ondrejh/keg_scale/doc/ptt2/dac_wiring.jpg

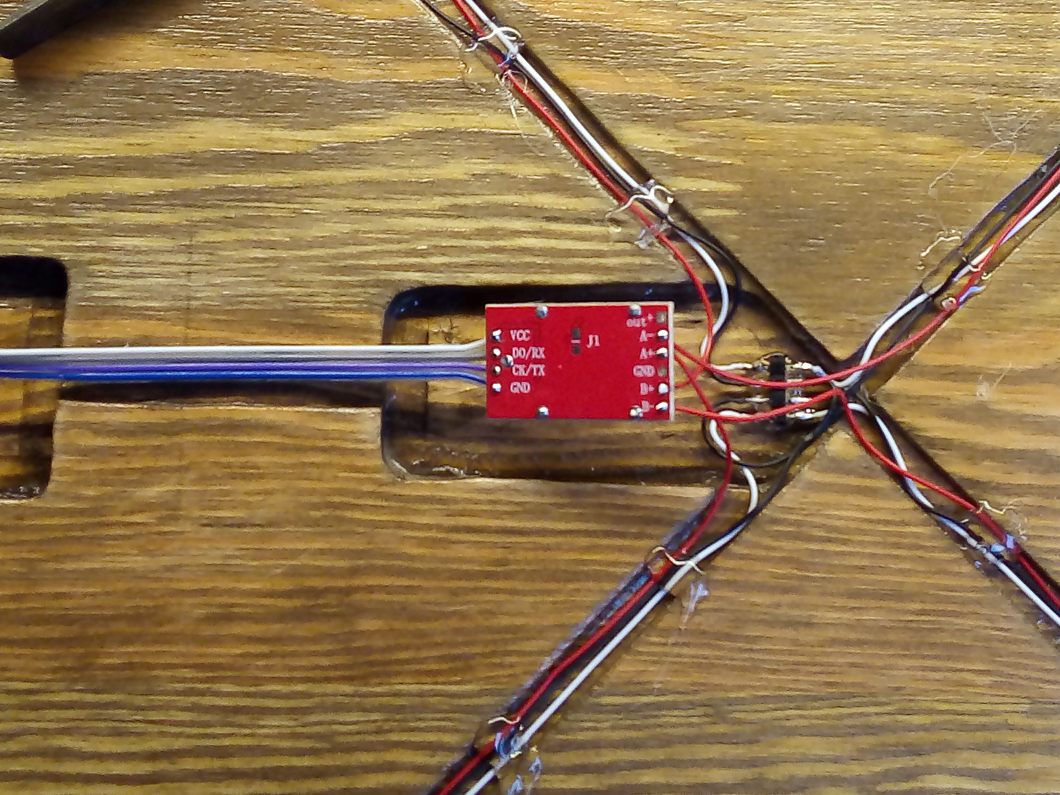
doc/ptt2/dac_wiring.jpg
