ondrejh/keg_scale/doc/gauge/gauge_prototype.jpg

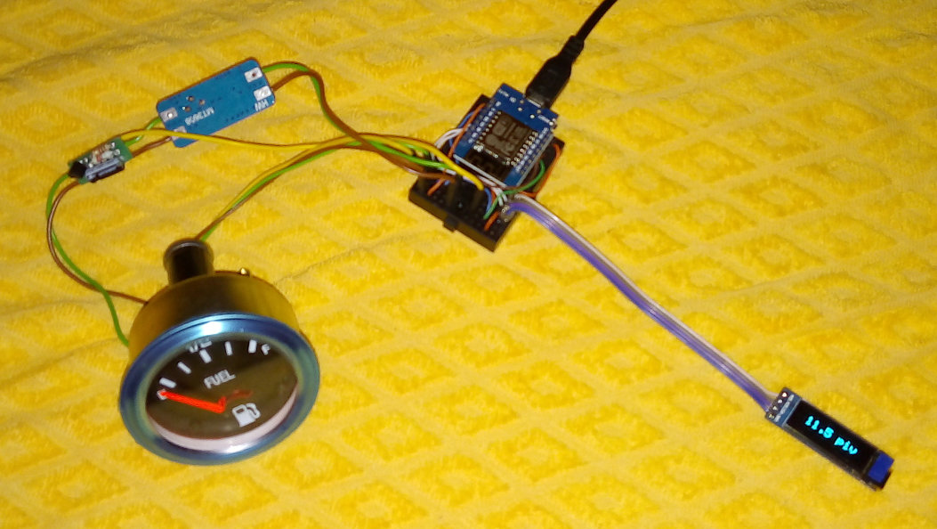
doc/gauge/gauge_prototype.jpg
