ondrejh/keg_scale/doc/hw1/keg01.png

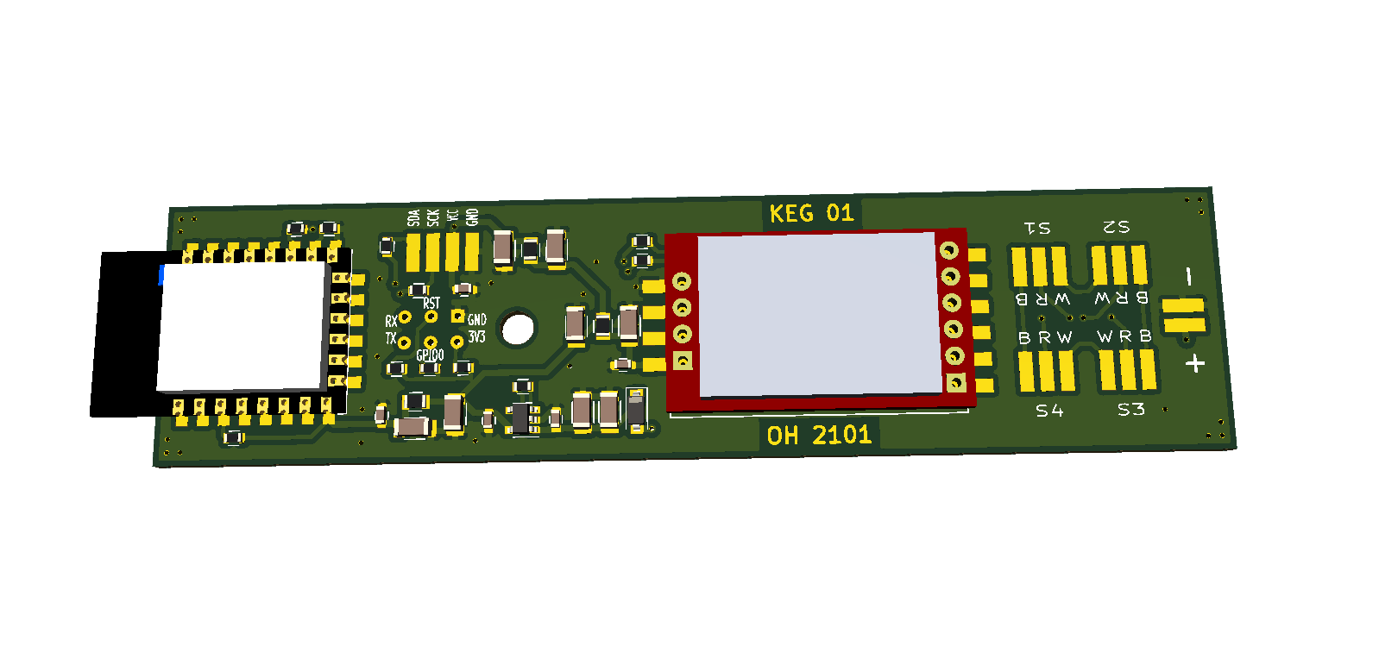
doc/hw1/keg01.png
