ondrejh/keg_scale/doc/hw1/prog.png

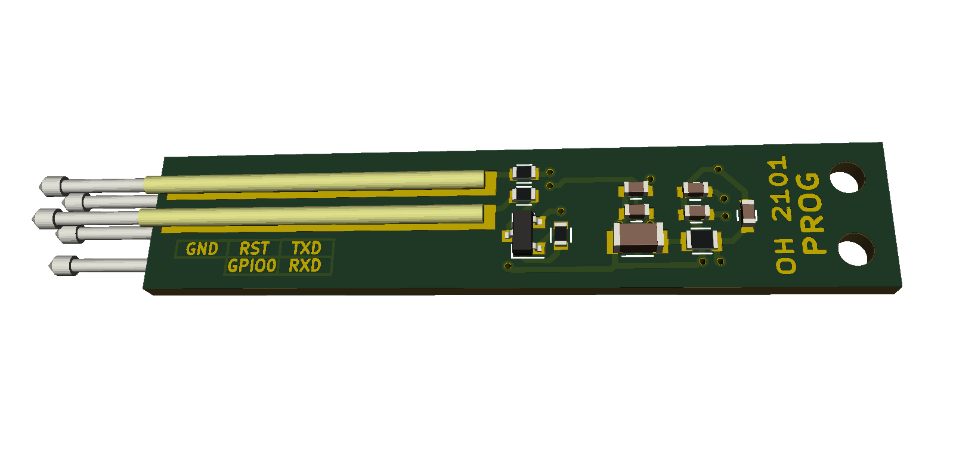
doc/hw1/prog.png
