ondrejh/keg_scale/doc/hw2/keg02.png

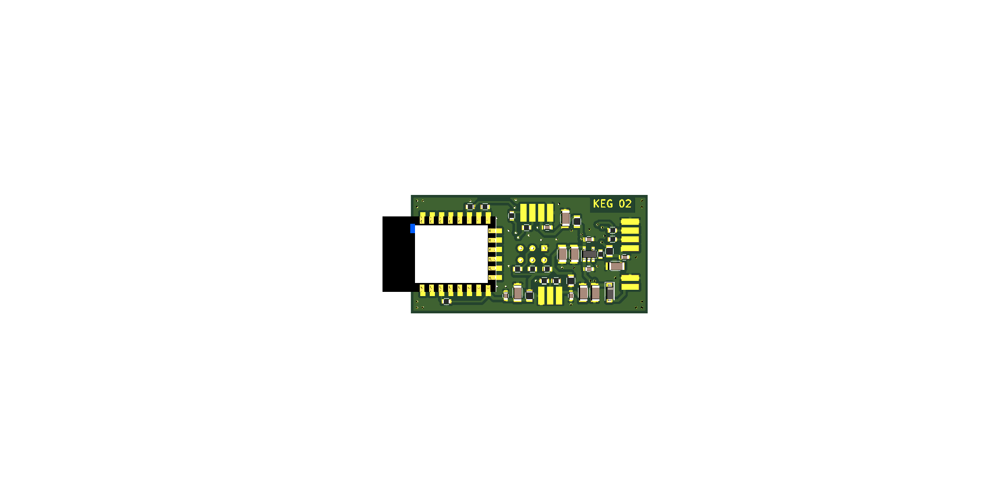
doc/hw2/keg02.png
