ondrejh/keg_scale/model/TO-92_Inline.step

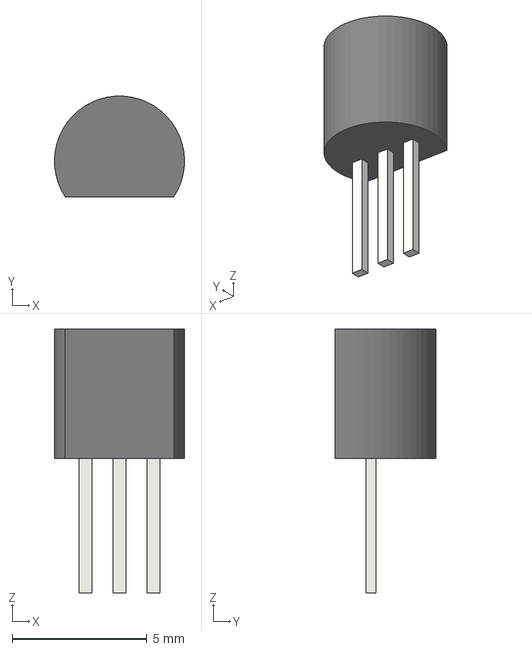
[picture p6: CAD file, 2021-11-08]
model/TO-92_Inline.step
4.83 x 3.74 x 9.80 mm
