ondrejh/keg_scale/schematic/keg01/keg01.step

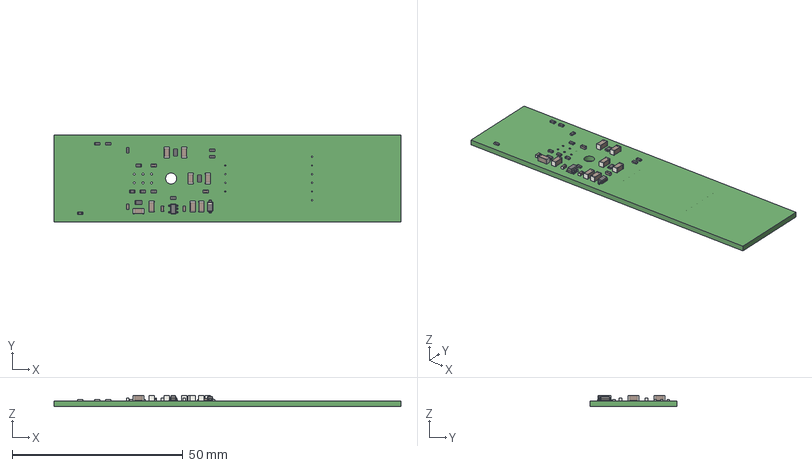
[picture p7: CAD file, 2021-03-22]
schematic/keg01/keg01.step
101.6 x 25.4 x 3.25 mm
hx711_shl
ESP-12E
