ondrejh/keg_scale/model/base_plate_small.FCStd

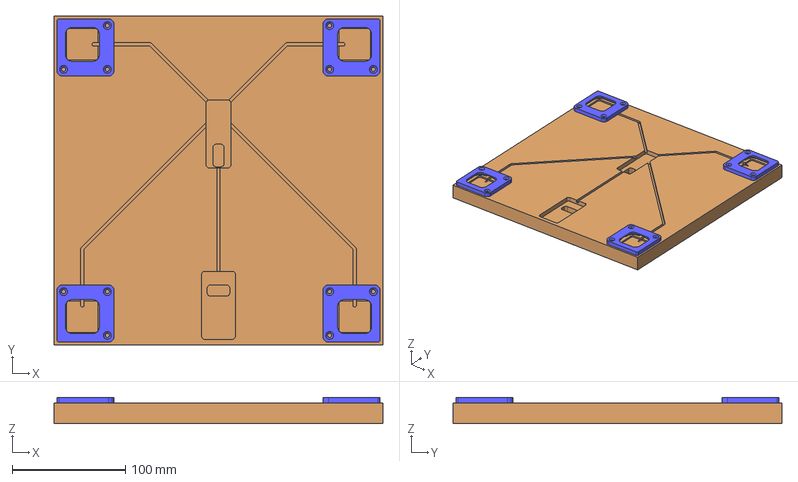
[picture p8: CAD file, 2021-11-08]
model/base_plate_small.FCStd
290.0 x 290.0 x 23.0 mm
teleso_male
noha1
noha2
noha3
noha4
OLED_0.91_128x034
