ondrejh/keg_scale/model/Cella_car.stp

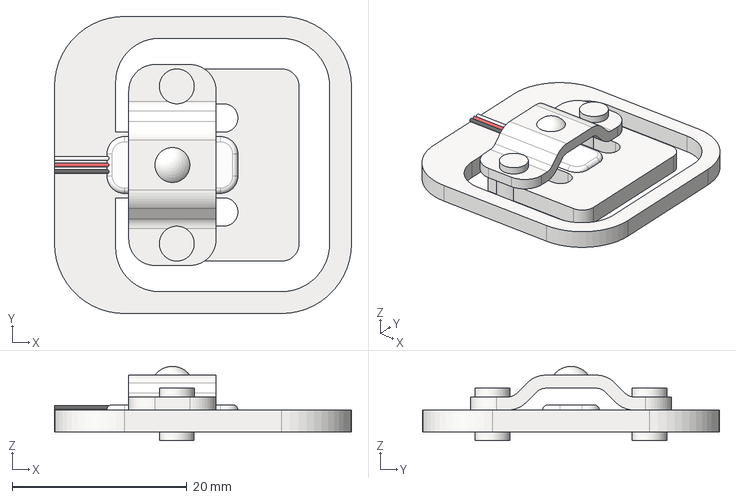
[picture p9: CAD file, 2021-05-28]
model/Cella_car.stp
34.0 x 34.0 x 8.50 mm
