ondrejh/keg_scale/model/BC559B.step

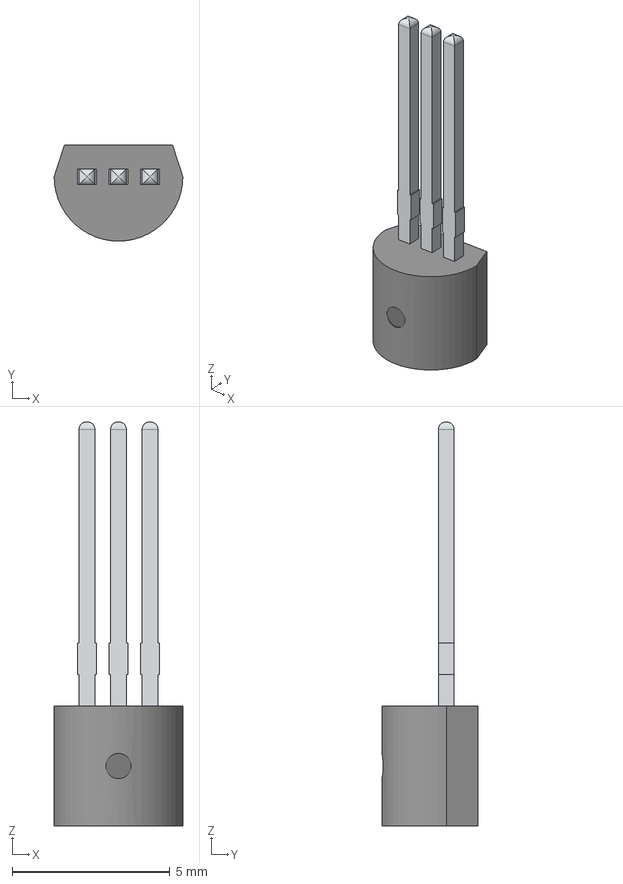
[picture p10: CAD file, 2021-05-28]
model/BC559B.step
4.08 x 3.05 x 12.8 mm
