ondrejh/keg_scale/model/Euro Keg 30L.stp

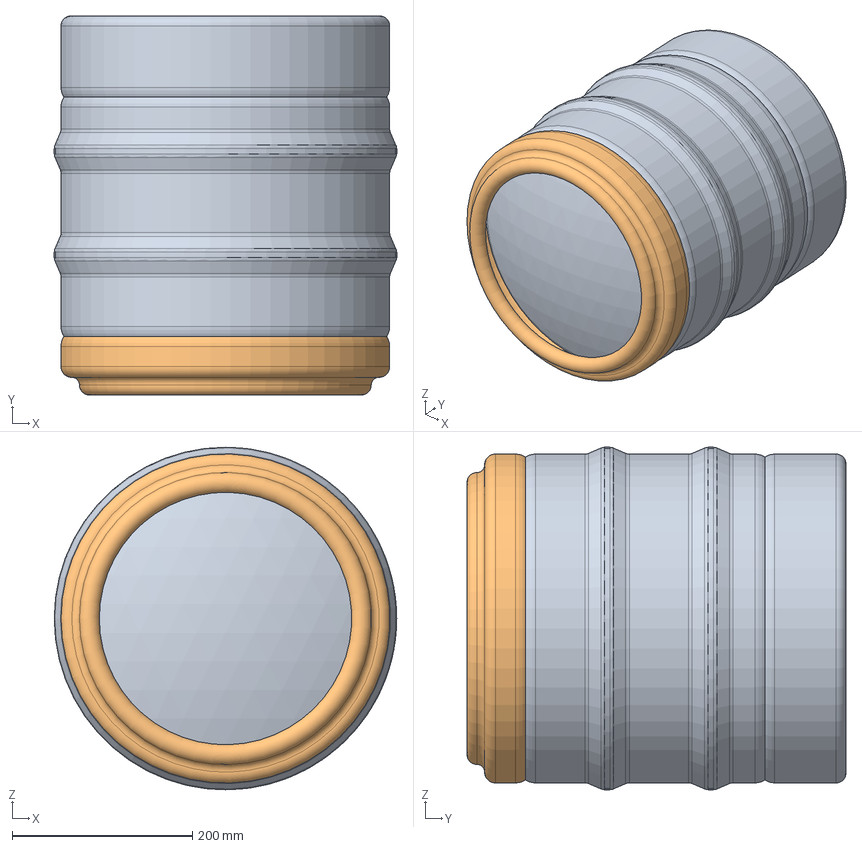
[picture p11: CAD file, 2021-05-28]
model/Euro Keg 30L.stp
380.0 x 420.5 x 380.0 mm
