ondrejh/keg_scale/model/USB Type-C Plug -1.STEP

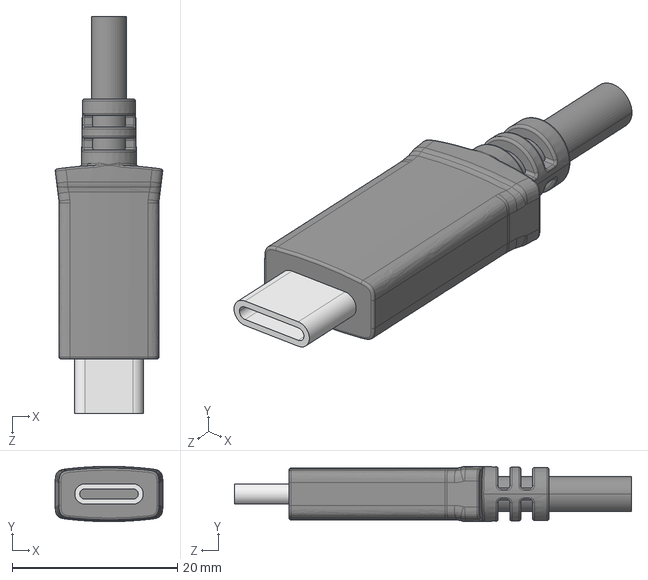
[picture p12: CAD file, 2021-05-28]
model/USB Type-C Plug -1.STEP
13.0 x 6.70 x 48.1 mm
