ondrejh/keg_scale/model/Micro USB Plug.step

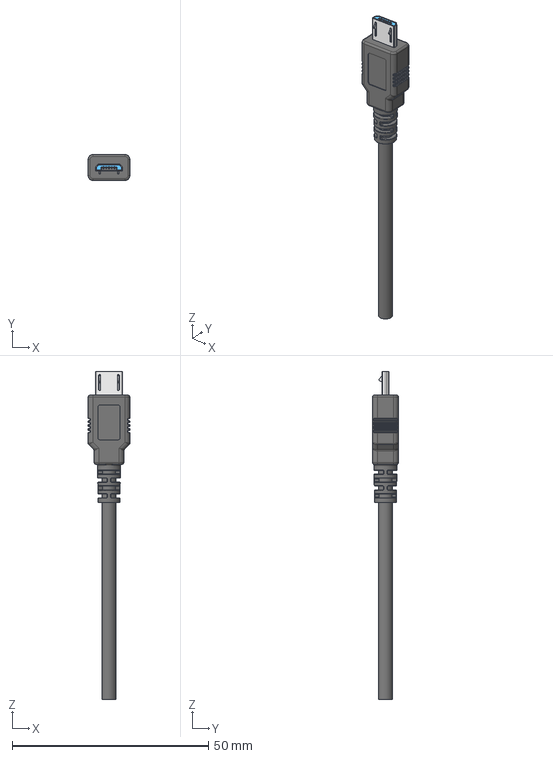
[picture p13: CAD file, 2021-05-28]
model/Micro USB Plug.step
10.6 x 6.60 x 83.5 mm
Cable
Micro_USB_Plug_Connector
