ondrejh/keg_scale/model/pogo.FCStd

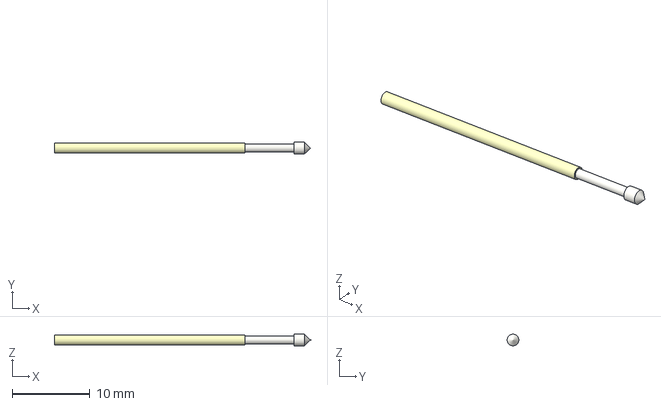
[picture p15: CAD file, 2021-01-06]
model/pogo.FCStd
33.0 x 1.50 x 1.50 mm
HOLDER
PIN
