ondrejh/keg_scale/model/hx711.FCStd

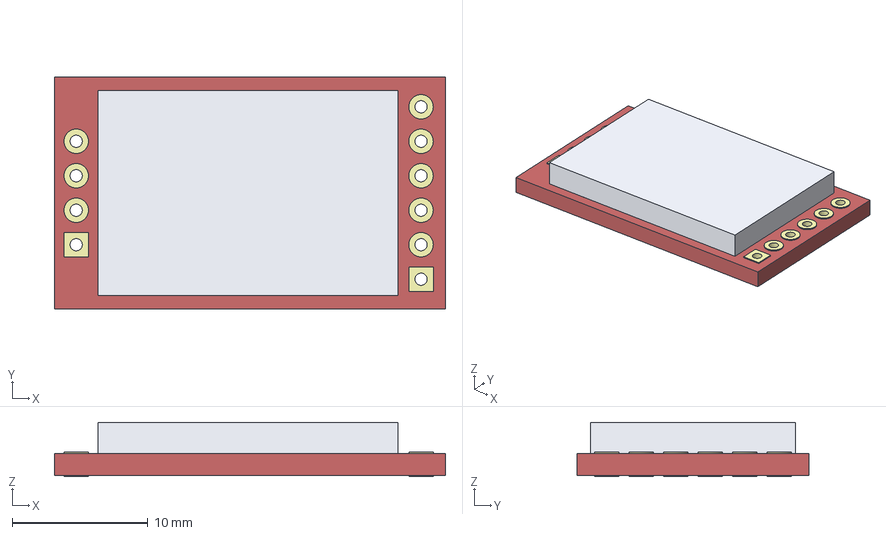
[picture p16: CAD file, 2021-01-05]
model/hx711.FCStd
28.8 x 17.1 x 4.00 mm
PCB
RoundPad01
SquarePad01
RoundPad02
RoundPad03
RoundPad04
RoundPad05
RoundPad06
RoundPad07
RoundPad08
SquarePad02
Cover
