ondrejh/keg_scale/model/vaha1.stp

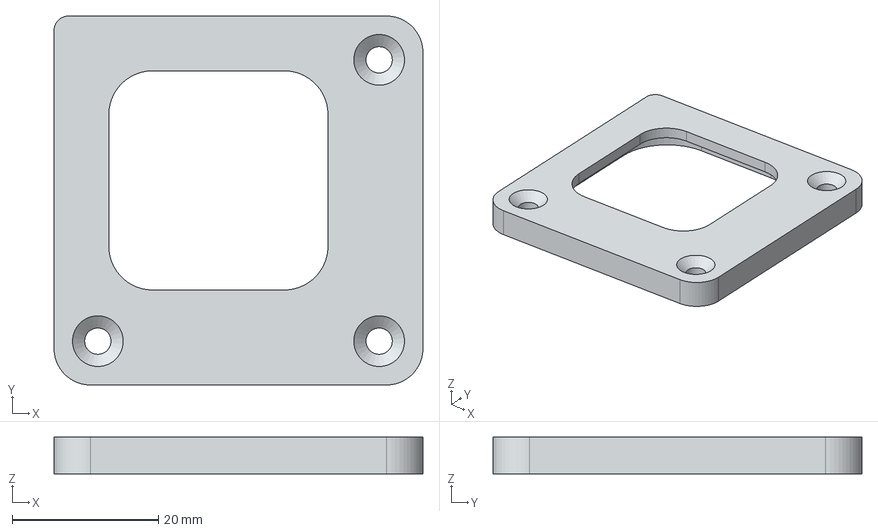
[picture p17: CAD file, 2020-05-13]
model/vaha1.stp
50.5 x 50.5 x 5.00 mm
