ondrejh/keg_scale/(list of files, cad)

Other CAD files:
model/vaha1.stl
