ondrejh/keg_scale/doc/base_plate_small-spodek.pdf

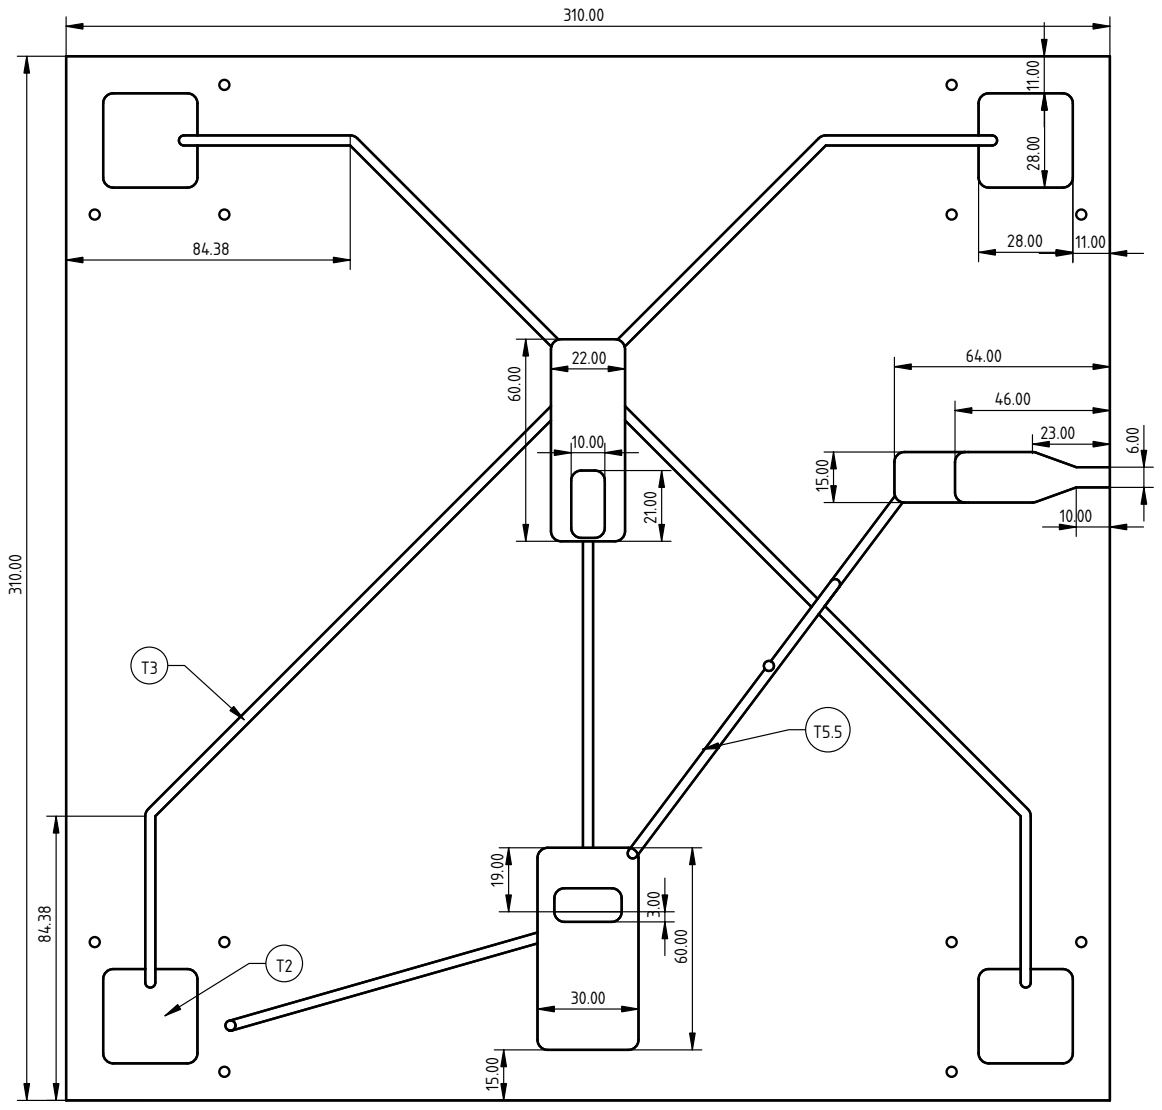
[picture p18: page 1]
