ondrejh/keg_scale/doc/base_plate_small-vrsek.pdf

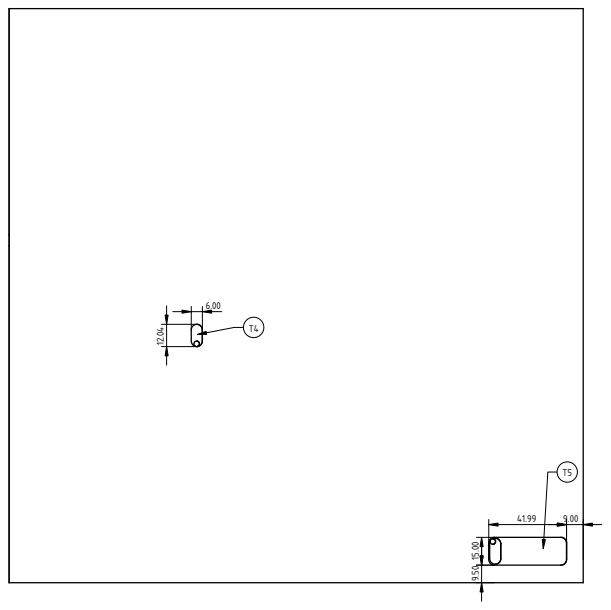
[picture p19: page 1]
