ondrejh/keg_scale/schematic/gauge_folower.asc

C1: cap; 10µ
Q1: npn
R1: res; 200
R2: res; 33k
R3: res; 10k
R4: res; 33k
U1: OP727
U2: OP727
V1: voltage; 12
V2: voltage; PULSE(0 3.3 0 0 0 0.99m 1m)
Named nets: 0
.tran 2
