ondrejh/keg_scale/schematic/keg02/keg02.kicad_pcb

## KiCad design schematic/keg02/keg02.kicad_pcb (2021-05-28)

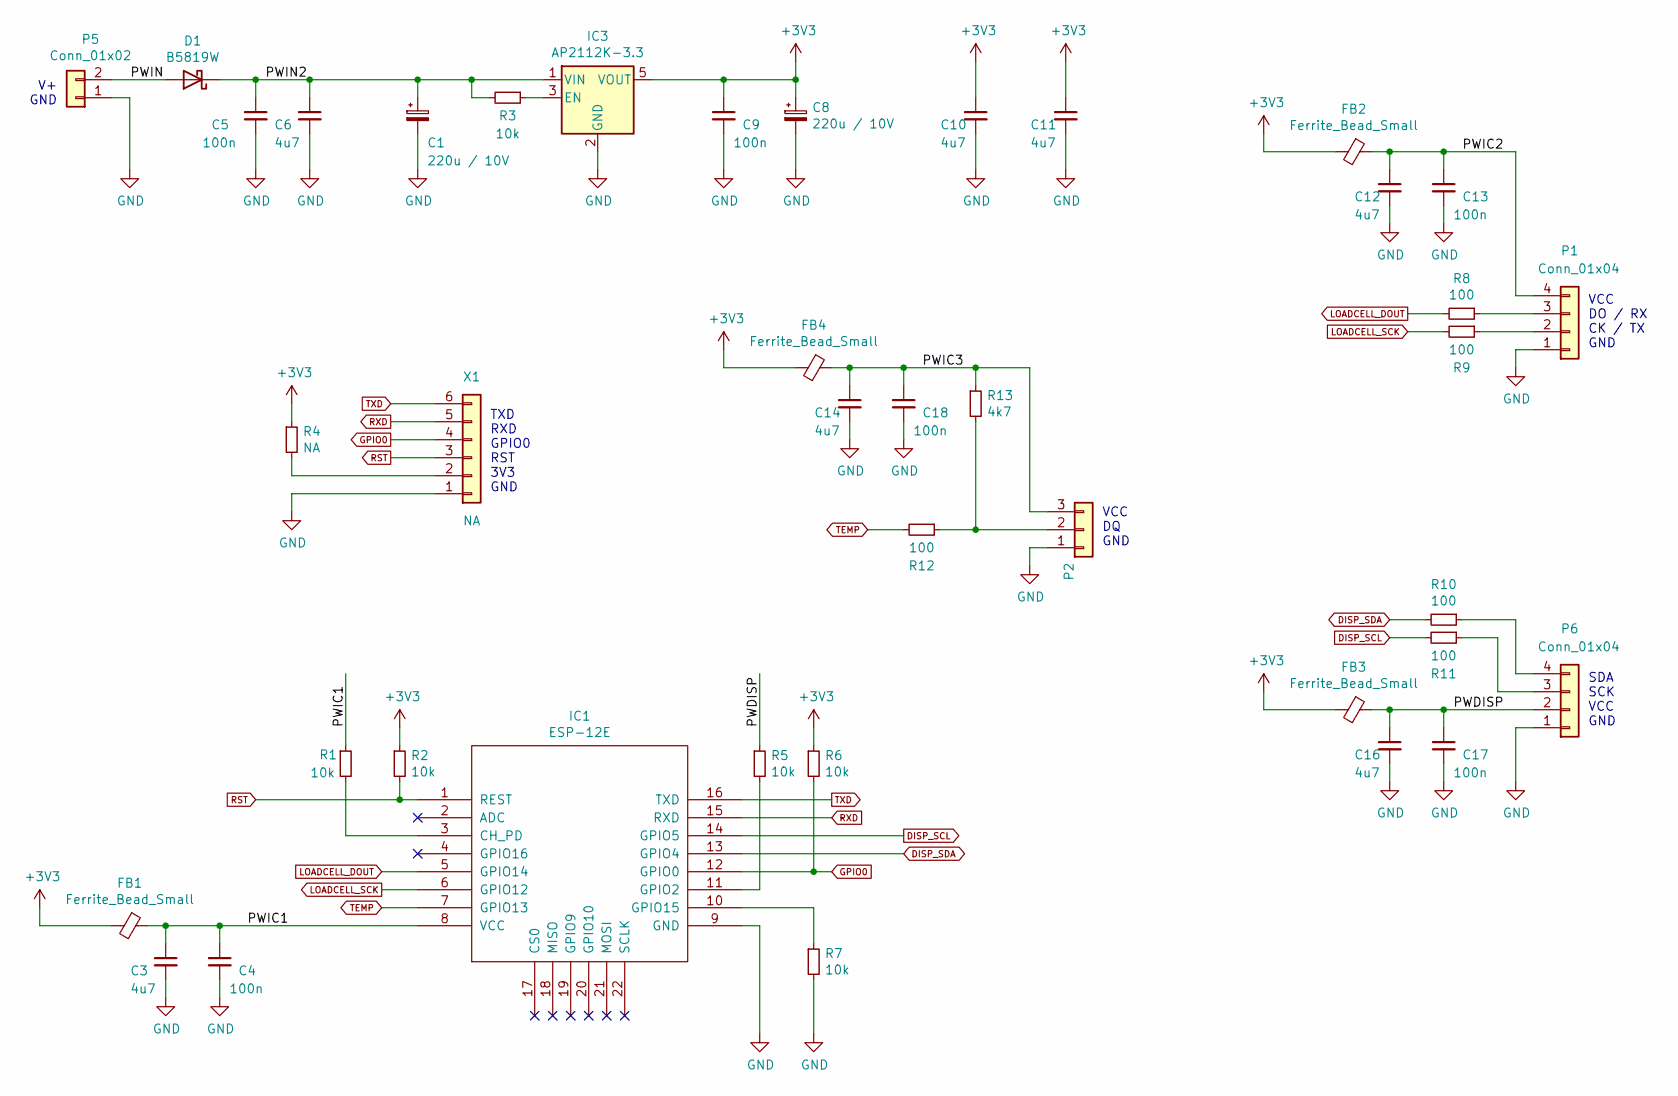
[picture p20: schematic keg02.sch]

Parts:
C1, C8: 220u / 10V; CP_Elec_6.3x7.7
C3, C6, C10, C11, C12, C14, C16: 4u7; C_1206
C4, C5, C9, C13, C17, C18: 100n; C_0603
D1: B5819W; D_SOD-123
FB1, FB2, FB3, FB4: Ferrite_Bead_Small; R_0805
IC1: ESP-12E; ESP-12E_SMD
IC3: AP2112K-3.3; SOT-23-5
P1, P6: Conn_01x04; DISP_CONN
P2: Conn_01x03; LC_CONN
P5: Conn_01x02; PWR_CONN
R1, R2, R3, R5, R6, R7: 10k; R_0603
R4: NA; R_0603
R8, R9, R10, R11, R12: 100; R_0603
R13: 4k7; R_0603
X1: NA; PROG_CON

Connections:
+3V3: C8.1, C9.1, C10.1, C11.1, FB1.2, FB2.2, FB3.2, FB4.2, IC3.5 (VOUT), R2.1, R4.1, R6.1
/PWDISP: C16.1, C17.1, FB3.1, P6.2, R5.1
/PWIC1: C3.1, C4.1, FB1.1, IC1.8 (VCC), R1.1
/PWIC2: C12.1, C13.1, FB2.1, P1.4
/PWIC3: C14.1, C18.1, FB4.1, P2.3, R13.1
/PWIN: D1.2 (A), P5.2
/PWIN2: C1.1, C5.1, C6.1, D1.1 (K), IC3.1 (VIN), R3.2
DISP_SCL: IC1.14 (GPIO5), R11.2
DISP_SDA: IC1.13 (GPIO4), R10.2
GND: C1.2, C3.2, C4.2, C5.2, C6.2, C8.2, C9.2, C10.2, C11.2, C12.2, C13.2, C14.2, C16.2, C17.2, C18.2, IC1.9 (GND), IC3.2 (GND), P1.1, P2.1, P5.1, P6.1, R7.2, X1.1
GPIO0: IC1.12 (GPIO0), R6.2, X1.4
LOADCELL_DOUT: IC1.5 (GPIO14), R8.2
LOADCELL_SCK: IC1.6 (GPIO12), R9.2
unnamed: IC1.3 (CH_PD), R1.2
unnamed: IC1.10 (GPIO15), R7.1
unnamed: IC1.11 (GPIO2), R5.2
unnamed: IC3.3 (EN), R3.1
unnamed: P1.2, R9.1
unnamed: P1.3, R8.1
unnamed: P2.2, R12.1, R13.2
unnamed: P6.3, R11.1
unnamed: P6.4, R10.1
unnamed: R4.2, X1.2
RST: IC1.1 (REST), R2.2, X1.3
RXD: IC1.15 (RXD), X1.5
TEMP: IC1.7 (GPIO13), R12.2
TXD: IC1.16 (TXD), X1.6

Notes on the sheet:
TXD RXD GPIO0 RST 3V3 GND
SDA SCK VCC GND
V+ GND
VCC DO / RX CK / TX GND
VCC DQ GND

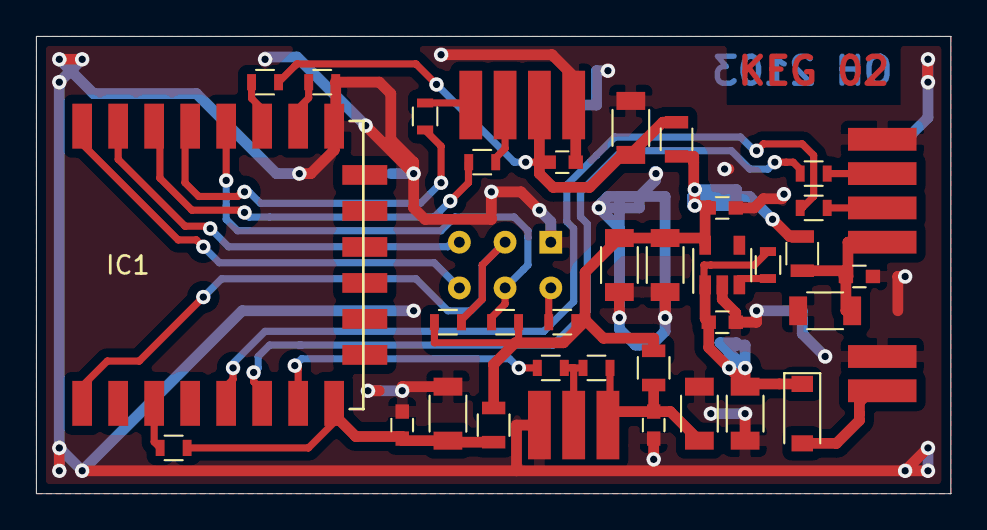
[picture p21: board keg02.kicad_pcb from above]

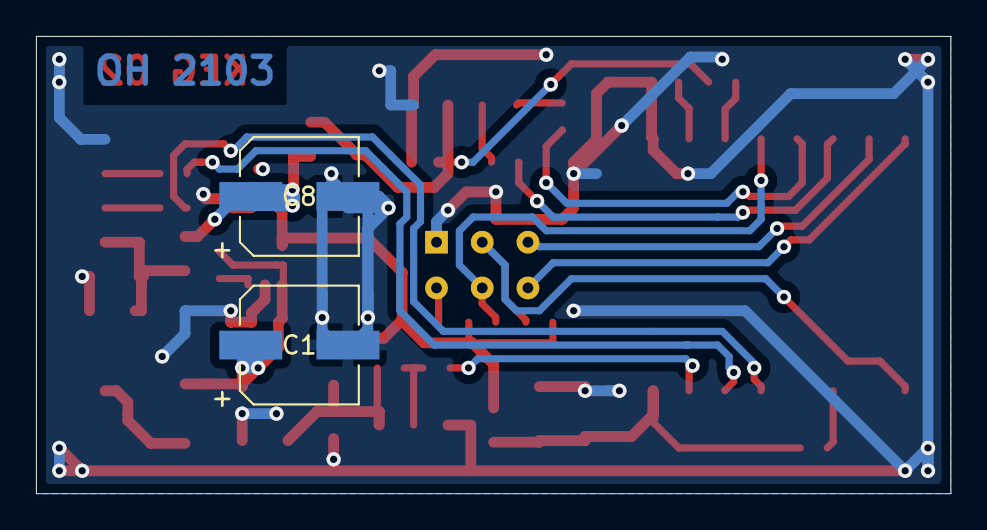
[picture p22: board keg02.kicad_pcb from below]

Board: 2 copper layers, 50.8 x 25.4 mm, 40 parts (2 on the bottom side), 27 nets.
