ondrejh/keg_scale/schematic/splitter/splitter.kicad_pcb

## KiCad design schematic/splitter/splitter.kicad_pcb (2021-04-04)

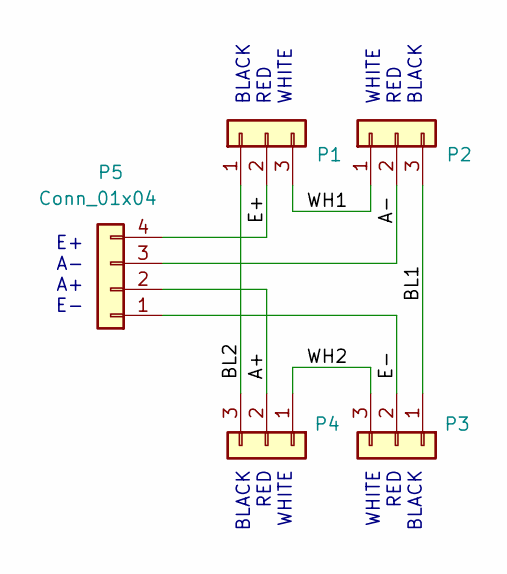
[picture p23: schematic splitter.sch]

Parts:
P1, P2, P3, P4: Conn_01x03; LC_CONN
P5: Conn_01x04; DISP_CONN

Connections:
/A+: P4.2, P5.2
/A-: P2.2, P5.3
/BL1: P2.3, P3.1
/BL2: P1.1, P4.3
/E+: P1.2, P5.4
/E-: P3.2, P5.1
/WH1: P1.3, P2.1
/WH2: P3.3, P4.1

Notes on the sheet:
WHITE RED BLACK
BLACK RED WHITE
E+ A- A+ E-

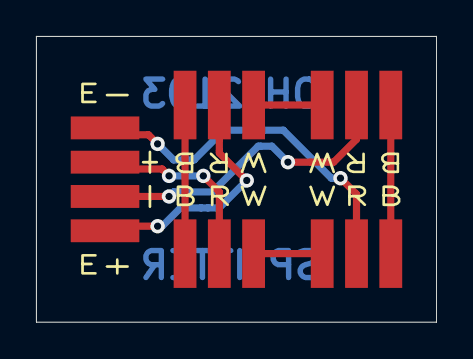
[picture p24: board splitter.kicad_pcb from above]

Board: 2 copper layers, 22.2 x 15.9 mm, 5 parts (0 on the bottom side), 8 nets.
