ondrejh/keg_scale/sketch/keg_scale/keg_scale.ino

/**
 * keg_scale
 * 
 * versions:
 *   v0.3 .. whispler on kegs
 *   v0.4 .. no AP mode, display temperature and wifi info
 *   v0.4.1 .. no-cache on json 
 *   v0.5 .. no jquerry (much lighter webi)
 *   v0.6 .. mqtt integration
 * 
 * done:
 *   individual device and ssid name
 *   new webi using post
 *   allow calib save - restore (do.php?addc=xx&rawc=yy)
 *   store config data
 *   whisplerign on kegs name
 *   save at least 10 last keg names for whispler
 * 
 * todo:
 *   connect to mqtt (home assistant)
 */

#define NOAP true

#include "HX711.h"

#include <Wire.h>
#include <Adafruit_GFX.h>
#include <Adafruit_SSD1306.h>

#include <ESP8266WiFi.h>
#include <ESP8266WebServer.h>
#include <ESP8266mDNS.h>

#include <PubSubClient.h>

#include <EEPROM.h>

#include <OneWire.h>

#include "webi.h"

#include <WiFiClient.h>

#define DISP_START_TIMEOUT 10000
#define DISP_WEIGHT_TIMEOUT 30000
#define DISP_TEMPERATURE_TIMEOUT 5000
#define DISP_WIFI_TIMEOUT 3000

const char* sw_version = "0.6 alpha";

OneWire  ds(D7);  // WEMOS D1 MINI, on pin D0 (a 4.7K resistor is necessary)
//OneWire  ds(D8);  // on pin 10 (a 4.7K resistor is necessary)

// home assistant mqtt
const int MQTT_PORT = 1883;
bool mqtt_status = false;
#define MQTT_SEND_PERIOD_MS 5000

float temperature;
int16_t raw_temp = 0;
bool temperature_valid = false;

// HX711 circuit wiring
const int LOADCELL_DOUT_PIN = D5;
const int LOADCELL_SCK_PIN = D6;

HX711 scale;

const int WLED = BUILTIN_LED;
const int SLED = 16;
#define ON 0
#define OFF 1

#define MESS 16
int32_t scale_mess[MESS];
uint32_t mess_ptr = 0;
int32_t scale_avg = 0;
float scale_units = 0.0;

#define EEPROM_SIZE 1024

// calibration data
#define EEPROM_CALIB_ADDR 0
#define UNIT_STR_MAX 8
#define CLBLEN 5
typedef struct {
  uint8_t p; // number of calb point used
  int32_t x[CLBLEN]; // calibration points x (raw)
  float y[CLBLEN]; // calibration points y (primary unit)
  float us; // secondary units = primary units * us
  char uprim[UNIT_STR_MAX + 1]; // primary unit name
  char usec[UNIT_STR_MAX + 1]; // secondary unit name
} calib_t;

calib_t calib;

#define EEPROM_KEG_ADDR (2+sizeof(calib_t))
#define KEG_LABEL_MAX 32
#define KEG (keg.keg)
typedef struct {
  bool keg;
  char label[KEG_LABEL_MAX + 1];
  float volume;
  int32_t fullraw;
} keg_t;

keg_t keg;

#define EEPROM_CONF_ADDR (EEPROM_KEG_ADDR+2+sizeof(keg_t))
#define CONF_SSID_MAX 16
#define CONF_PWD_MAX 16
#define CONF_URL_MAX 64
#define CONF_USR_MAX 16
typedef struct {
  // wifi settings
  char ssid[CONF_SSID_MAX+1];
  char wpwd[CONF_PWD_MAX+1];
  // mqtt settings
  char mqtt_url[CONF_URL_MAX+1];
  char mqtt_topic[CONF_URL_MAX+1];
  char mqtt_user[CONF_USR_MAX+1];
  char mqtt_pass[CONF_PWD_MAX+1];
} conf_t;

conf_t conf;

#define DEFAULT_KEG_LIST "Krakonoš 11°\nPrimátor 11°\nKrakonoš 10°\nKrakonoš 12°\nSvijany 11°\nRadegast 12°\nBernard 11°\nPrimátor 12°"
#define EEPROM_KEGLIST_ADDR (EEPROM_CONF_ADDR+2+sizeof(conf_t))
#define KEG_LIST_MAX_LENGTH ((KEG_LABEL_MAX+1)*10)
typedef struct {
  char kegs[KEG_LIST_MAX_LENGTH];
} keglist_t;

keglist_t keglist;

float keg_left;
float keg_full;

#define SCALE_PERIOD 200 //ms

// display
#define SCREEN_WIDTH 128 // OLED display width, in pixels
#define SCREEN_HEIGHT 32 // OLED display height, in pixels
#define OLED_RESET     -1 // Reset pin # (or -1 if sharing Arduino reset pin)
Adafruit_SSD1306 display(SCREEN_WIDTH, SCREEN_HEIGHT, &Wire, OLED_RESET);

// wifi ap settings
char ssid[16] = "keg123456";
const char *password = "k3Gat0rr";

bool AP_Mode = true;

WiFiClient client;
PubSubClient mqttClient(client);
IPAddress brokerIP;

ESP8266WebServer server(80);

void mqtt_reconnect() {
  // MQTT reconnect loop
  if (!mqttClient.connected()) {
    Serial.print("Connecting to MQTT... ");

    // CONNECT WITH USER + PASSWORD
    if (conf.mqtt_user[0]!='\0') {
      //if (mqttClient.connect(idstr, mqttUser, mqttPassword)) {
      if (mqttClient.connect(ssid, conf.mqtt_user, conf.mqtt_pass)) {
        Serial.println("connected!");
      }
      else {
        Serial.print("failed, rc=");
        Serial.println(mqttClient.state());
      }
    }

    // CONNECT (NO USER)
    else {
      if (mqttClient.connect(ssid)) {
        Serial.println("connected!");
      }
      else {
        Serial.print("failed, rc=");
        Serial.println(mqttClient.state());
      }
    }
  }
}

void setup() {
  Serial.begin(115200);

  pinMode(WLED, OUTPUT);
  digitalWrite(WLED, OFF);
  pinMode(SLED, OUTPUT);
  digitalWrite(SLED, OFF);

  pinMode(D7, OUTPUT);
  digitalWrite(D7, HIGH);

  // init eeprom data
  init_eeprom(EEPROM_SIZE);
  if (eeload(EEPROM_CALIB_ADDR, &calib, sizeof(calib)) < 0)
    set_calib_default(&calib);
  if (eeload(EEPROM_KEG_ADDR, &keg, sizeof(keg)) < 0)
    keg.keg = false;
  if (eeload(EEPROM_CONF_ADDR, &conf, sizeof(conf)) < 0)
    set_conf_default(&conf);
  if (eeload(EEPROM_KEGLIST_ADDR, &keglist, sizeof(keglist)) < 0)
    set_keglist_default(&keglist);

  /*// test reading conf data
  delay(500);
  Serial.println("Configuration");
  Serial.println();
  Serial.print("  SSID: ");
  Serial.println(conf.ssid);
  Serial.print("  WPWD: ");
  Serial.println(conf.wpwd);
  Serial.print("  DKEY: ");
  Serial.println(conf.dkey);
  Serial.print("  PIN: ");
  Serial.println(conf.pin);
  Serial.println();
  delay(500);*/

  // if keg initialize live data
  if (KEG) {
    keg_full = interpolate(keg.fullraw);
    keg_left = keg.volume;
  }

  // SSD1306_SWITCHCAPVCC = generate display voltage from 3.3V internally
  if(!display.begin(SSD1306_SWITCHCAPVCC, 0x3C))// Address 0x3C for 128x32
    Serial.println(F("SSD1306 allocation failed"));

  // show initial display buffer contents on the screen
  display.display();
  display_intro();

  uint8_t mac[6];
  WiFi.macAddress(mac);
  sprintf(ssid, "keg%02X%02X%02X", mac[3], mac[4], mac[5]);

  if (conf.ssid[0] != '\0') {
    AP_Mode = false;
    WiFi.mode(WIFI_STA);
    WiFi.begin(conf.ssid, conf.wpwd);
    // Wait for connection
    Serial.print("Connecting WiFi ");
    int cnt = 0;
    while (WiFi.status() != WL_CONNECTED) {
      delay(500);
      Serial.print(".");
      cnt ++;
      if (cnt > 30)
        break;
    }
    if (WiFi.status() == WL_CONNECTED) {
      Serial.println(" OK");
      Serial.println(WiFi.localIP());
    }
    else {
      Serial.println(" ERROR (timeout)");
      AP_Mode = true;
    }
  }
  
  if (AP_Mode) {
    // start the access point
    WiFi.mode(WIFI_AP);
    IPAddress ip(192, 168, 42, 1);
    IPAddress subnet(255, 255, 255, 0);
    WiFi.softAPConfig(ip, ip, subnet);
    WiFi.softAP(ssid, password);
    Serial.print("Access Point \"");
    Serial.print(ssid);
    Serial.println("\" started");
    Serial.print("IP address:\t");
    Serial.println(WiFi.softAPIP());
  }

  // init scale
  scale.begin(LOADCELL_DOUT_PIN, LOADCELL_SCK_PIN);
  pinMode(LOADCELL_DOUT_PIN, INPUT);

  if (MDNS.begin(ssid))
    Serial.println("MDNS responder started");

  // mdns setup
  server.on("/", handleRoot);
  server.on(index_name, handleRoot);
  server.on(keg_name, handleKegstart);
  server.on(calib_name, handleCalibration);
  server.on(config_name, handleConfiguration);
  server.on(sass_style_name, handleStyle);
  server.on(favicon_name, handleFavicon);
  server.on("img/favicon.ico", handleFavicon);
  server.on(img_bg_name, handleBg);
  server.on(img_barell_name, handleBarell);

  server.on(img_favicon_32x32_name, handleFavicon32);
  server.on(img_favicon_16x16_name, handleFavicon16);
  server.on(img_apple_touch_icon_name, handleAppleIcon);
  server.on(img_android_chrome_512x512_name, handleAndroid512);
  server.on(img_android_chrome_192x192_name, handleAndroid192);
  server.on(img_site_name, handleSite);
  
  //server.on(jquery_3_name, handleJquery);
  //server.on(jquery_ui_1_name, handleJqueryUi);
  server.on("/data.json", handleData);
  server.on("/conf.json", handleConfData);
  server.on("/do.php", HTTP_POST, handleDo);
  server.on("/keglist.txt", handleList);
  server.onNotFound(handleNotFound);

  server.begin();
  Serial.println("HTTP server started");

  if (!AP_Mode) {
    // Resolve broker hostname
    if (conf.mqtt_url[0] != '\0') {
      if (WiFi.hostByName(conf.mqtt_url, brokerIP)) {
        Serial.print("MQTT server: ");
        Serial.print(brokerIP);
        Serial.print(":");
        Serial.println(MQTT_PORT);
        mqttClient.setServer(brokerIP, MQTT_PORT);
      } else {
        Serial.println("Resolve failed");
      }
    }
  }
  // display wifi connection
  if (AP_Mode) {
    IPAddress dip = WiFi.softAPIP();
    display_wifi(ssid, dip);
  }
  else {
    IPAddress dip = WiFi.localIP();
    display_wifi(conf.ssid, dip);
  }
}

void loop() {
  // http server
  server.handleClient();
  MDNS.update();
  
  // scale reading
  static uint32_t scale_tim = 0;
  uint32_t now = millis();
  if (((now - scale_tim) >= SCALE_PERIOD) && (scale.is_ready())) {
    scale_tim = now;
    digitalWrite(SLED, ON);

    int32_t reading = scale.read();
    if (reading != -1) {
      scale_avg -= scale_mess[mess_ptr];
      scale_mess[mess_ptr] = reading;
      scale_avg += scale_mess[mess_ptr++];
      mess_ptr %= MESS;
      //Serial.println(scale_avg);
      scale_units = interpolate(scale_avg);
    }
    
    digitalWrite(SLED, OFF);
  }

  // temperature
  static uint32_t temp_tim = 0;
  static int temp_state = 0;
  //now = millis();
  switch (temp_state) {
  case 0:
    temp_tim = now;
    ds.reset();
    ds.skip();
    ds.write(0x44,1);
    temp_state ++;
    break;
  case 1:
    if ((now - temp_tim) >= 1000) {
      byte present = ds.reset();
      byte data[9];
      ds.skip();    
      ds.write(0xBE); // Read Scratchpad

      if (!present) {
        temp_state = 3;
        break;
      }
      else {
        for ( int i = 0; i < 9; i++)
          data[i] = ds.read();
        if (OneWire::crc8( data, 9) == 0) {
          static bool first = true;
          if (first) {
            temp_state = 3;
            first = false;
            break;
          }
          else {
            int16_t raw = (data[1] << 8) | data[0];
            byte cfg = (data[4] & 0x60);
            if (cfg == 0x00) raw = raw & ~7;  // 9 bit resolution, 93.75 ms
            else if (cfg == 0x20) raw = raw & ~3; // 10 bit res, 187.5 ms
            else if (cfg == 0x40) raw = raw & ~1; // 11 bit res, 375 ms
            temperature = (float)raw / 16.0;
            temperature_valid = true;
            raw_temp = raw;
            Serial.println(temperature);
          }
        } else {
          temp_state = 3;
          break;
        }
      }
      temp_state++;
    }
    break;
  case 2:
    if ((now - temp_tim) >= 30000) {
      temp_state = 0;
    }
    break;
  case 3:
    if ((now - temp_tim) >= 1200) {
      temp_state = 0;
    }
    break;
  }

  // display
  static uint32_t disp_tim = 0;
  static int disp_state = 0;
  static int disp_update = 0;
  static uint32_t disp_timeout = DISP_START_TIMEOUT;
  static uint32_t last_scale_units = 0;
  if ((now - disp_tim) >= disp_timeout) {
    disp_tim = now;  
    switch (disp_state) {
      case 0:
        // switch to "weight"
        disp_state ++;
        disp_update = 1;
        disp_timeout = DISP_WEIGHT_TIMEOUT;
        last_scale_units = 0;
      break;
      case 1:
        // switch to "temperature"
        disp_state ++;
        if (temperature_valid) {
          disp_timeout = DISP_TEMPERATURE_TIMEOUT;
          display_temp(raw_temp * 10 / 16);
        }
        else
          disp_timeout = 0;
        disp_update = 0;
      break;
      case 2:
        // switch to "weight"
        disp_state ++;
        disp_timeout = DISP_WEIGHT_TIMEOUT;
        last_scale_units = 0;
        disp_update = 1;
      break;
      case 3:        
      default:
        // switch to "network"
        disp_timeout = DISP_WIFI_TIMEOUT;
        disp_state = 0;
        disp_update = 0;
        {
          if (AP_Mode)
            display_wifi(ssid, WiFi.softAPIP());
          else
            display_wifi(conf.ssid, WiFi.localIP());
        }
      break;
    }
  }

  switch (disp_update) {
    case 0: // network & temp (static - no update)
    break;
    case 1: // weight
      if (last_scale_units != scale_units) {
        if (KEG) {
          keg_left = keg.volume - (keg_full - scale_units) / calib.us;
          display_units(keg_left, (char*)"");//calib.usec);
        }
        else
          display_units(scale_units, calib.uprim);
        last_scale_units = scale_units;
      }
    break;
    default:
    break;
  }

  // MQTT
  if (!AP_Mode) {
    if (conf.mqtt_url[0] != '\0') {
      static uint32_t pushM = now;
      if ((now - pushM) >= MQTT_SEND_PERIOD_MS) {
        if (!mqttClient.connected()) {
          mqtt_reconnect();
        }
        if (mqttClient.connected()) {
          mqtt_status = true;

          // Create JSON payload
          String json = build_mqtt(); 


          // publish json
          //Serial.print("Publish: ");
          //Serial.println(json);
          mqttClient.publish(conf.mqtt_topic, json.c_str());
          mqttClient.loop();
        }
        else {
          mqtt_status = false;
        }
        pushM = millis();
      }
    }
    else {
      mqtt_status = false;
    }
  }
}
