ondrejh/keg_scale/hx711test/hx711test.ino

#include "HX711.h"

// HX711 circuit wiring
const int LOADCELL_DOUT_PIN = D5;
const int LOADCELL_SCK_PIN = D6;

HX711 scale;

// the setup function runs once when you press reset or power the board
void setup() {
 // init scale
  scale.begin(LOADCELL_DOUT_PIN, LOADCELL_SCK_PIN);
  pinMode(LOADCELL_DOUT_PIN, INPUT);
  
  // initialize digital pin LED_BUILTIN as an output.
  pinMode(LED_BUILTIN, OUTPUT);

  Serial.begin(115200);
}

// the loop function runs over and over again forever
void loop() {
  int32_t reading = scale.read();
  Serial.println(reading);
  
  digitalWrite(LED_BUILTIN, HIGH);   // turn the LED on (HIGH is the voltage level)
  delay(1000);                       // wait for a second
  digitalWrite(LED_BUILTIN, LOW);    // turn the LED off by making the voltage LOW
  delay(1000);                       // wait for a second
}
