ondrejh/keg_scale/(commit log)

2020-05-08 ajax: timeout, and fail handling
    [keg_scale.ino]
2020-05-08 calibration in put (webi) and data output (sketch)
2020-05-08 calibration table output
2020-05-08 refactorise (function prototypes)
2020-05-08 add and delete calibrations
2020-05-08 eeprom calibration storage
2020-05-10 calibration page
2020-05-12 temperature sensor
2020-05-13 longterm stability measureement
    [log.csv]
2020-05-13 special folder for diagnostics
    [log.csv]
2020-05-13 sensor holder
    [vaha1.stl, vaha1.stp]
2020-05-13 error measurement (glued sensor)
    [log_glued.csv]
2020-05-14 new measurement data
    [log.csv]
2020-05-14 new measurement
    [log_free.csv]
2020-12-25 simulation - keep calibration
2020-12-25 one button, no hiding
2020-12-28 calibration add value using post (backend)
2020-12-30 calibration can be forced
2020-12-31 calibration save and restore script
2021-01-03 specific device calibration
2021-01-04 hw v01 - schematic and basic layout (need routing)
    [keg01.kicad_pcb, keg01.sch]
2021-01-05 hx711 module model
    [hx711.FCStd]
2021-01-05 programmer tag schematic
    [prog.kicad_pcb, prog.sch]
2021-01-06 programing connector layout
    [keg01.kicad_pcb, prog.kicad_pcb, prog.sch]
2021-01-06 programming connector gerber
2021-01-06 pogo pin model
    [pogo.FCStd]
2021-01-06 keg01 gerber
2021-01-07 panelizing markers and adjustment
    [keg01.kicad_pcb, prog.kicad_pcb]
2021-01-07 voltage follower for gauge display
2021-02-11 different device
2021-03-22 gauge booster output
    [gauge_booster.sch]
2021-03-22 gauge prototype
2021-03-25 2nd version of hw
    [keg02.kicad_pcb, keg02.sch]
2021-03-25 gerber data and bom
    [keg02.kicad_pcb]
2021-03-25 splitter pcb
    [splitter.kicad_pcb, splitter.sch]
2021-03-25 splitter gerber
2021-04-07 keg02 rendered image (doc)
    [keg02.kicad_pcb, keg02.sch, power.sch, usb_power.sch]
2021-05-19 large scale model
    [Cella_car.stp, Euro Keg 30L.stp, Micro USB Plug.step, OLED_0.91_128x32.stp, USB Type-C Plug -1.STEP]
2021-05-22 model plus teplomer
    [BC559B.step]
2021-05-23 small base model
    [base_plate_small.FCStd]
2021-06-29 FCADEB calibration data
2021-07-02 new scale, new calibration file
2021-10-14 esp matrix driver
2021-10-31 bom update
    [keg02.sch]
2021-11-08 ds18 temp
    [TO-92_Inline.step, base_plate_small.FCStd]
2021-11-08 small plate
2021-11-25 more display info (network and temperature)
2021-12-13 calibration list
